lvd2/yolka/hw/5v_4a_psu/dev_tps53015/dev_tps53015.kicad_pcb

## KiCad design hw/5v_4a_psu/dev_tps53015/dev_tps53015.kicad_pcb (2026-11-06)

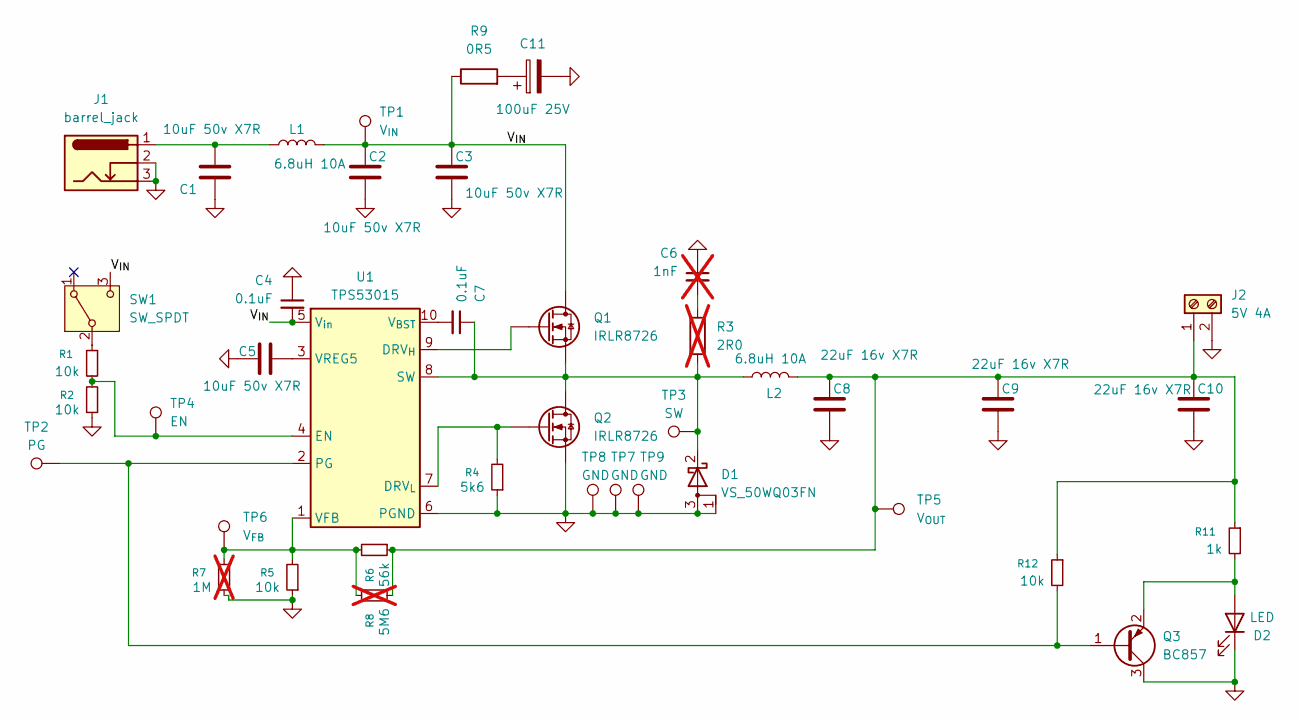
[picture p1: schematic dev_tps53015.kicad_sch]

Parts:
C1, C2, C3, C5: 10uF 50v X7R; C_1210_3225Metric_Pad1.33x2.70mm_HandSolder
C4, C7: 0.1uF; C_0805_2012Metric_Pad1.18x1.45mm_HandSolder
C6: 1nF; C_0805_2012Metric_Pad1.18x1.45mm_HandSolder; not fitted
C8, C9, C10: 22uF 16v X7R; C_1210_3225Metric_Pad1.33x2.70mm_HandSolder
C11: 100uF 25V; CP_Radial_D6.3mm_P2.50mm
D1: VS_50WQ03FN; TO-252-2
D2: LED; LED_0805_2012Metric
J1: barrel_jack; BarrelJack_Horizontal
J2: 5V 4A; KF7.62-2
L1, L2: 6.8uH 10A; univ_12x12_inductor
Q1, Q2: IRLR8726; TO-252-FET
Q3: BC857; SOT-23_Handsoldering
R1, R2, R5, R12: 10k; R_0805_2012Metric_Pad1.20x1.40mm_HandSolder
R3: 2R0; R_1206_3216Metric_Pad1.30x1.75mm_HandSolder; not fitted
R4: 5k6; R_0805_2012Metric_Pad1.20x1.40mm_HandSolder
R6: 56k; R_0805_2012Metric_Pad1.20x1.40mm_HandSolder
R7: 1M; R_0805_2012Metric_Pad1.20x1.40mm_HandSolder; not fitted
R8: 5M6; R_0805_2012Metric_Pad1.20x1.40mm_HandSolder; not fitted
R9: 0R5; R_1206_3216Metric_Pad1.30x1.75mm_HandSolder
R11: 1k; R_0805_2012Metric_Pad1.20x1.40mm_HandSolder
SW1: SW_SPDT; SW_SPDT_PCM12
TP1: V_{IN}; PinHeader_1x01_P2.54mm_Vertical
TP2: PG; PinHeader_1x01_P2.54mm_Vertical
TP3: SW; PinHeader_1x01_P2.54mm_Vertical
TP4: EN; PinHeader_1x01_P2.54mm_Vertical
TP5: V_{OUT}; PinHeader_1x01_P2.54mm_Vertical
TP6: V_{FB}; PinHeader_1x01_P2.54mm_Vertical
TP7, TP8, TP9: GND; PinHeader_1x01_P2.54mm_Vertical
U1: TPS53015; VSSOP-10_3x3mm_P0.5mm

Connections:
/V_{IN}: C2.1, C3.1, C4.2, L1.2, Q1.D, R9.1, SW1.3 (C), TP1.1, U1.5 (V_{in})
GND: C1.2, C2.2, C3.2, C4.1, C5.2, C6.1, C8.2, C9.2, C10.2, C11.2, D1.1 (A), D1.3 (A), D2.1 (K), J1.2, J1.3, J2.2, Q2.S, Q3.3 (C), R2.1, R4.1, R5.1, R7.1, SW1.4, TP7.1, TP8.1, TP9.1, U1.6 (PGND)
unnamed: C1.1, J1.1, L1.1
unnamed: C6.2, R3.1
unnamed: C11.1, R9.2
unnamed: C7.1, D1.2 (K), L2.1, Q1.S, Q2.D, R3.2, TP3.1, U1.8 (SW)
unnamed: D2.2 (A), Q3.2 (E), R11.2
unnamed: C8.1, C9.1, C10.1, J2.1, L2.2, R6.1, R8.1, R11.1, R12.1, TP5.1
unnamed: Q3.1 (B), R12.2, TP2.1, U1.2 (PG)
unnamed: R1.1, SW1.2 (B)
unnamed: Q1.G, U1.9 (DRV_{H})
unnamed: Q2.G, R4.2, U1.7 (DRV_{L})
unnamed: R1.2, R2.2, TP4.1, U1.4 (EN)
unnamed: R5.2, R6.2, R7.2, R8.2, TP6.1, U1.1 (VFB)
unnamed: C5.1, U1.3 (VREG5)
unnamed: C7.2, U1.10 (V_{BST})

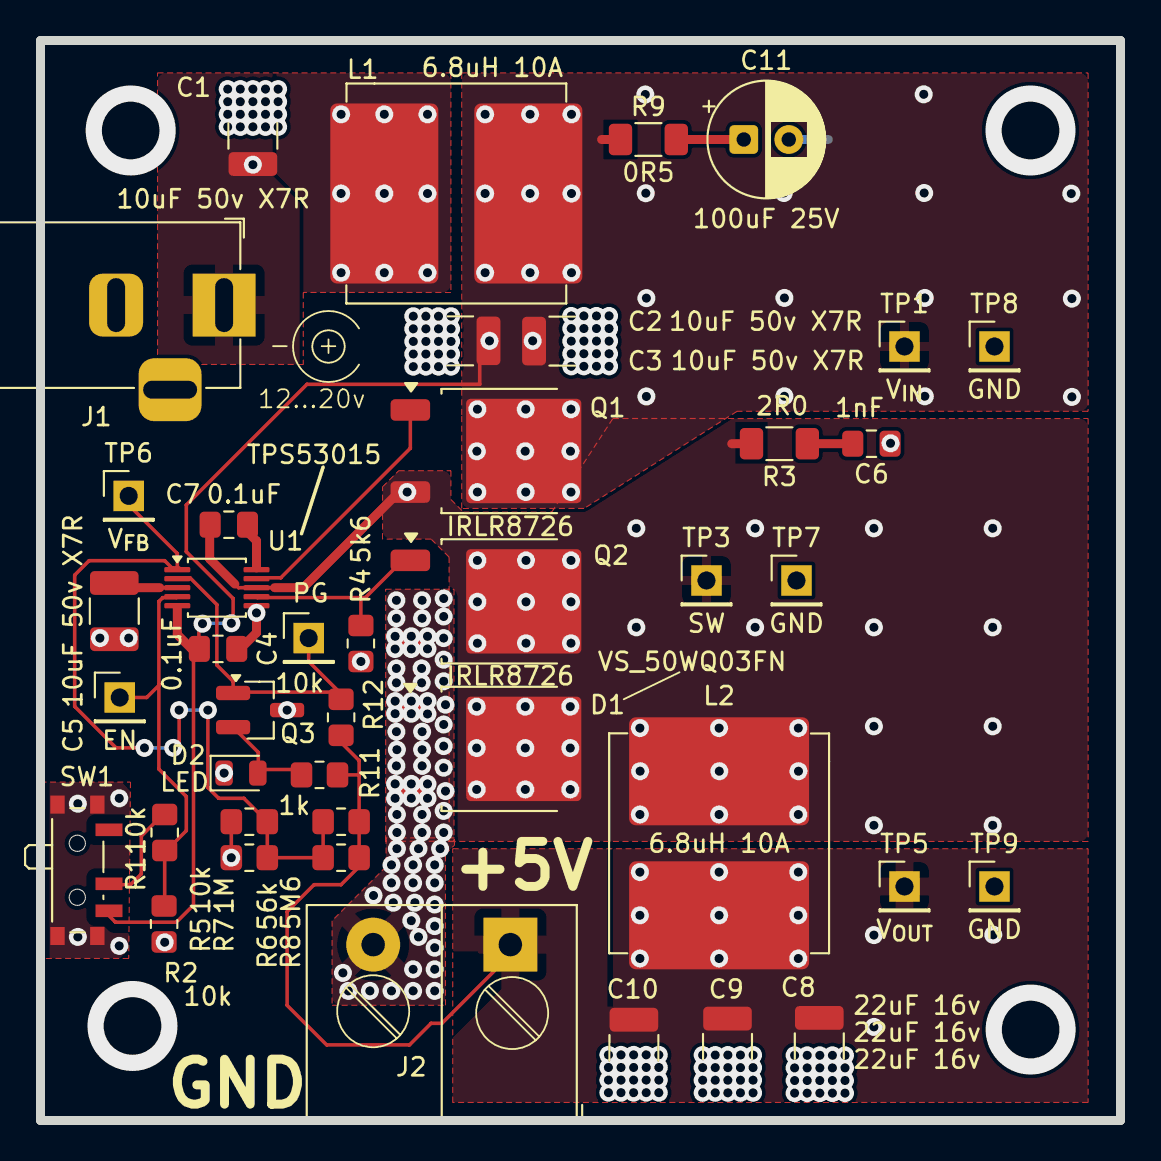
[picture p2: board dev_tps53015.kicad_pcb from above]

Board: 2 copper layers, 60.0 x 60.0 mm, 42 parts (0 on the bottom side), 16 nets.
