lvd2/yolka/hw/main_board/yolka/yolka.kicad_pcb

## KiCad design hw/main_board/yolka/yolka.kicad_pcb (2026-11-06)

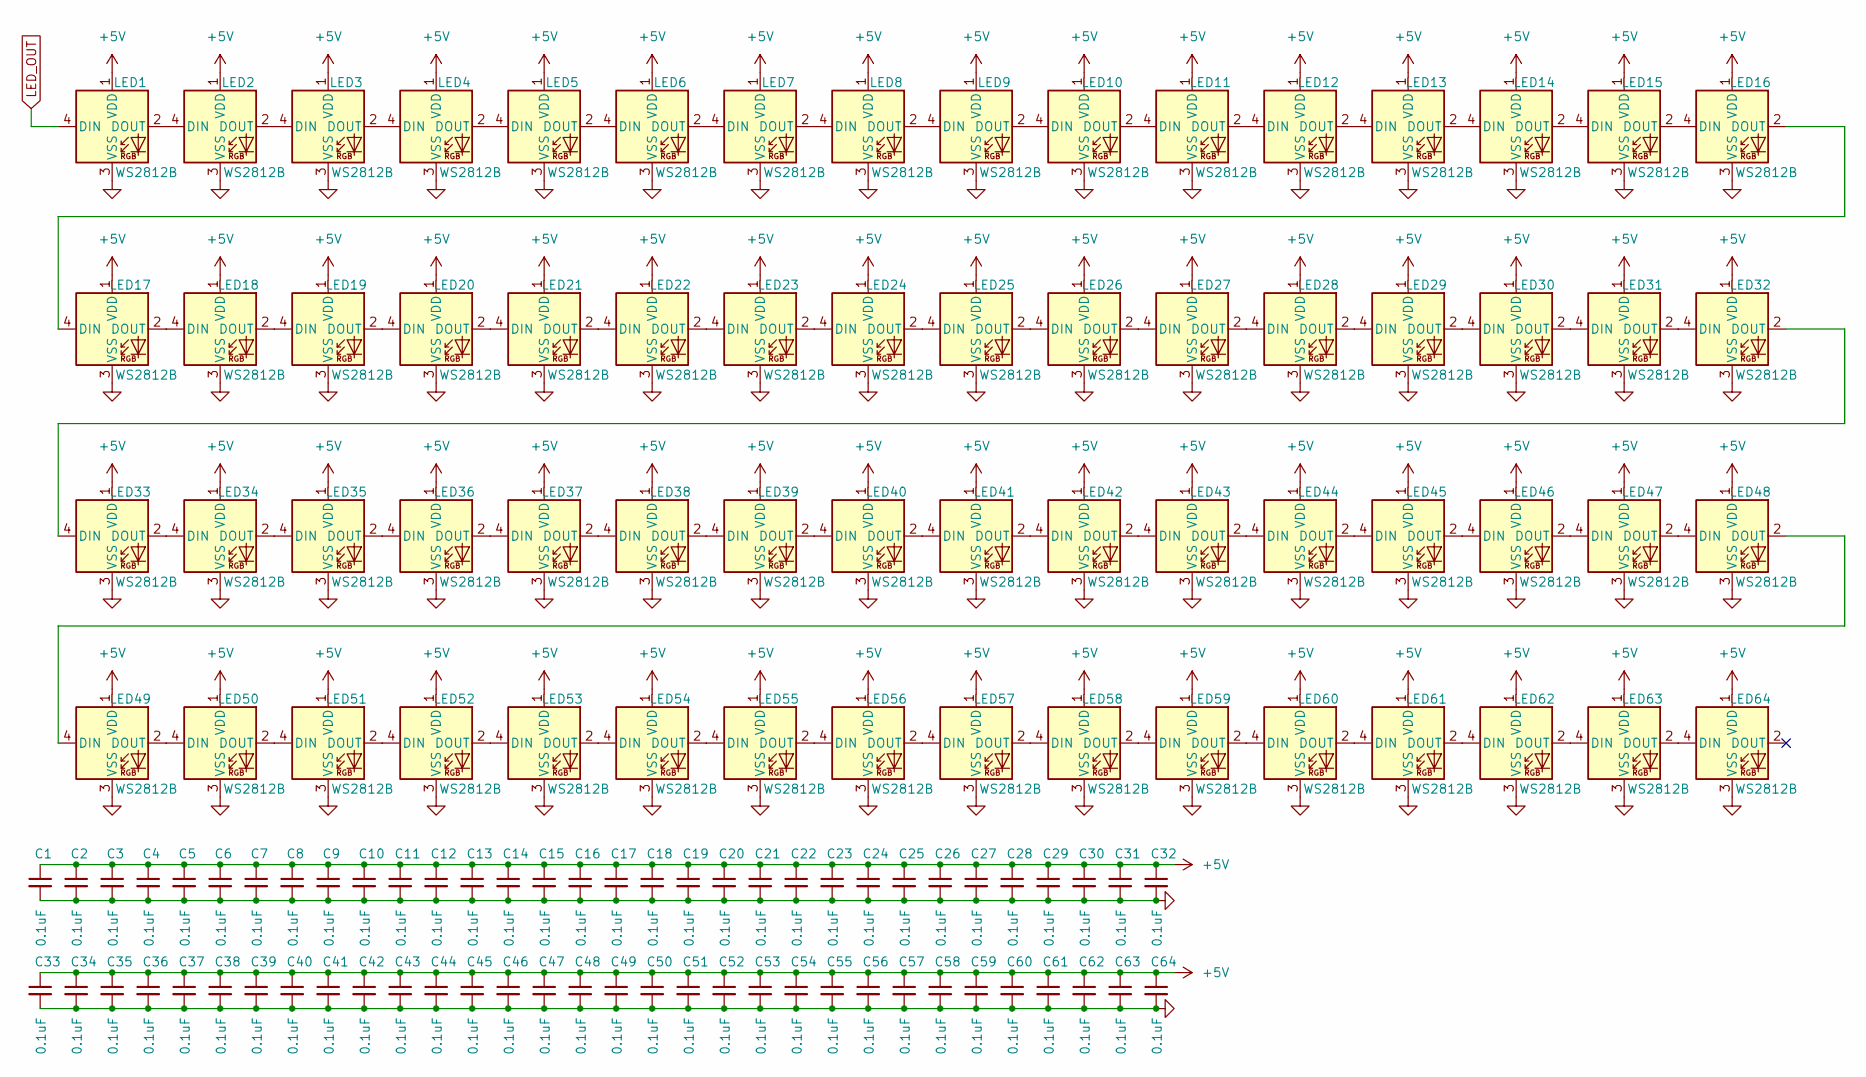
[picture p3: schematic leds.kicad_sch]

Parts:
C1, C2, C3, C4, C5, C6, C7, C8, C9, C10, C11, C12, C13, C14, C15, C16, C17, C18, C19, C20, C21, C22, C23, C24, C25, C26, C27, C28, C29, C30, C31, C32, C33, C34, C35, C36, C37, C38, C39, C40, C41, C42, C43, C44, C45, C46, C47, C48, C49, C50, C51, C52, C53, C54, C55, C56, C57, C58, C59, C60, C61, C62, C63, C64: 0.1uF; C_0805_2012Metric_Pad1.18x1.45mm_HandSolder
LED1, LED2, LED3, LED4, LED5, LED6, LED7, LED8, LED9, LED10, LED11, LED12, LED13, LED14, LED15, LED16, LED17, LED18, LED19, LED20, LED21, LED22, LED23, LED24, LED25, LED26, LED27, LED28, LED29, LED30, LED31, LED32, LED33, LED34, LED35, LED36, LED37, LED38, LED39, LED40, LED41, LED42, LED43, LED44, LED45, LED46, LED47, LED48, LED49, LED50, LED51, LED52, LED53, LED54, LED55, LED56, LED57, LED58, LED59, LED60, LED61, LED62, LED63, LED64: WS2812B; LED_WS2812B_PLCC4_5.0x5.0mm_P3.2mm

Connections:
+5V: C1.1, C2.1, C3.1, C4.1, C5.1, C6.1, C7.1, C8.1, C9.1, C10.1, C11.1, C12.1, C13.1, C14.1, C15.1, C16.1, C17.1, C18.1, C19.1, C20.1, C21.1, C22.1, C23.1, C24.1, C25.1, C26.1, C27.1, C28.1, C29.1, C30.1, C31.1, C32.1, C33.1, C34.1, C35.1, C36.1, C37.1, C38.1, C39.1, C40.1, C41.1, C42.1, C43.1, C44.1, C45.1, C46.1, C47.1, C48.1, C49.1, C50.1, C51.1, C52.1, C53.1, C54.1, C55.1, C56.1, C57.1, C58.1, C59.1, C60.1, C61.1, C62.1, C63.1, C64.1, LED1.1 (VDD), LED2.1 (VDD), LED3.1 (VDD), LED4.1 (VDD), LED5.1 (VDD), LED6.1 (VDD), LED7.1 (VDD), LED8.1 (VDD), LED9.1 (VDD), LED10.1 (VDD), LED11.1 (VDD), LED12.1 (VDD), LED13.1 (VDD), LED14.1 (VDD), LED15.1 (VDD), LED16.1 (VDD), LED17.1 (VDD), LED18.1 (VDD), LED19.1 (VDD), LED20.1 (VDD), LED21.1 (VDD), LED22.1 (VDD), LED23.1 (VDD), LED24.1 (VDD), LED25.1 (VDD), LED26.1 (VDD), LED27.1 (VDD), LED28.1 (VDD), LED29.1 (VDD), LED30.1 (VDD), LED31.1 (VDD), LED32.1 (VDD), LED33.1 (VDD), LED34.1 (VDD), LED35.1 (VDD), LED36.1 (VDD), LED37.1 (VDD), LED38.1 (VDD), LED39.1 (VDD), LED40.1 (VDD), LED41.1 (VDD), LED42.1 (VDD), LED43.1 (VDD), LED44.1 (VDD), LED45.1 (VDD), LED46.1 (VDD), LED47.1 (VDD), LED48.1 (VDD), LED49.1 (VDD), LED50.1 (VDD), LED51.1 (VDD), LED52.1 (VDD), LED53.1 (VDD), LED54.1 (VDD), LED55.1 (VDD), LED56.1 (VDD), LED57.1 (VDD), LED58.1 (VDD), LED59.1 (VDD), LED60.1 (VDD), LED61.1 (VDD), LED62.1 (VDD), LED63.1 (VDD), LED64.1 (VDD); also elsewhere on the board
GND: C1.2, C2.2, C3.2, C4.2, C5.2, C6.2, C7.2, C8.2, C9.2, C10.2, C11.2, C12.2, C13.2, C14.2, C15.2, C16.2, C17.2, C18.2, C19.2, C20.2, C21.2, C22.2, C23.2, C24.2, C25.2, C26.2, C27.2, C28.2, C29.2, C30.2, C31.2, C32.2, C33.2, C34.2, C35.2, C36.2, C37.2, C38.2, C39.2, C40.2, C41.2, C42.2, C43.2, C44.2, C45.2, C46.2, C47.2, C48.2, C49.2, C50.2, C51.2, C52.2, C53.2, C54.2, C55.2, C56.2, C57.2, C58.2, C59.2, C60.2, C61.2, C62.2, C63.2, C64.2, LED1.3 (VSS), LED2.3 (VSS), LED3.3 (VSS), LED4.3 (VSS), LED5.3 (VSS), LED6.3 (VSS), LED7.3 (VSS), LED8.3 (VSS), LED9.3 (VSS), LED10.3 (VSS), LED11.3 (VSS), LED12.3 (VSS), LED13.3 (VSS), LED14.3 (VSS), LED15.3 (VSS), LED16.3 (VSS), LED17.3 (VSS), LED18.3 (VSS), LED19.3 (VSS), LED20.3 (VSS), LED21.3 (VSS), LED22.3 (VSS), LED23.3 (VSS), LED24.3 (VSS), LED25.3 (VSS), LED26.3 (VSS), LED27.3 (VSS), LED28.3 (VSS), LED29.3 (VSS), LED30.3 (VSS), LED31.3 (VSS), LED32.3 (VSS), LED33.3 (VSS), LED34.3 (VSS), LED35.3 (VSS), LED36.3 (VSS), LED37.3 (VSS), LED38.3 (VSS), LED39.3 (VSS), LED40.3 (VSS), LED41.3 (VSS), LED42.3 (VSS), LED43.3 (VSS), LED44.3 (VSS), LED45.3 (VSS), LED46.3 (VSS), LED47.3 (VSS), LED48.3 (VSS), LED49.3 (VSS), LED50.3 (VSS), LED51.3 (VSS), LED52.3 (VSS), LED53.3 (VSS), LED54.3 (VSS), LED55.3 (VSS), LED56.3 (VSS), LED57.3 (VSS), LED58.3 (VSS), LED59.3 (VSS), LED60.3 (VSS), LED61.3 (VSS), LED62.3 (VSS), LED63.3 (VSS), LED64.3 (VSS); also elsewhere on the board
LED_OUT: LED1.4 (DIN); also elsewhere on the board
unnamed: LED1.2 (DOUT), LED2.4 (DIN)
unnamed: LED2.2 (DOUT), LED3.4 (DIN)
unnamed: LED3.2 (DOUT), LED4.4 (DIN)
unnamed: LED4.2 (DOUT), LED5.4 (DIN)
unnamed: LED5.2 (DOUT), LED6.4 (DIN)
unnamed: LED6.2 (DOUT), LED7.4 (DIN)
unnamed: LED7.2 (DOUT), LED8.4 (DIN)
unnamed: LED8.2 (DOUT), LED9.4 (DIN)
unnamed: LED9.2 (DOUT), LED10.4 (DIN)
unnamed: LED10.2 (DOUT), LED11.4 (DIN)
unnamed: LED11.2 (DOUT), LED12.4 (DIN)
unnamed: LED12.2 (DOUT), LED13.4 (DIN)
unnamed: LED13.2 (DOUT), LED14.4 (DIN)
unnamed: LED14.2 (DOUT), LED15.4 (DIN)
unnamed: LED15.2 (DOUT), LED16.4 (DIN)
unnamed: LED16.2 (DOUT), LED17.4 (DIN)
unnamed: LED17.2 (DOUT), LED18.4 (DIN)
unnamed: LED18.2 (DOUT), LED19.4 (DIN)
unnamed: LED19.2 (DOUT), LED20.4 (DIN)
unnamed: LED20.2 (DOUT), LED21.4 (DIN)
unnamed: LED21.2 (DOUT), LED22.4 (DIN)
unnamed: LED22.2 (DOUT), LED23.4 (DIN)
unnamed: LED23.2 (DOUT), LED24.4 (DIN)
unnamed: LED24.2 (DOUT), LED25.4 (DIN)
unnamed: LED25.2 (DOUT), LED26.4 (DIN)
unnamed: LED26.2 (DOUT), LED27.4 (DIN)
unnamed: LED27.2 (DOUT), LED28.4 (DIN)
unnamed: LED28.2 (DOUT), LED29.4 (DIN)
unnamed: LED29.2 (DOUT), LED30.4 (DIN)
unnamed: LED30.2 (DOUT), LED31.4 (DIN)
unnamed: LED31.2 (DOUT), LED32.4 (DIN)
unnamed: LED32.2 (DOUT), LED33.4 (DIN)
unnamed: LED33.2 (DOUT), LED34.4 (DIN)
unnamed: LED34.2 (DOUT), LED35.4 (DIN)
unnamed: LED35.2 (DOUT), LED36.4 (DIN)
unnamed: LED36.2 (DOUT), LED37.4 (DIN)
unnamed: LED37.2 (DOUT), LED38.4 (DIN)
unnamed: LED38.2 (DOUT), LED39.4 (DIN)
unnamed: LED39.2 (DOUT), LED40.4 (DIN)
unnamed: LED40.2 (DOUT), LED41.4 (DIN)
unnamed: LED41.2 (DOUT), LED42.4 (DIN)
unnamed: LED42.2 (DOUT), LED43.4 (DIN)
unnamed: LED43.2 (DOUT), LED44.4 (DIN)
unnamed: LED44.2 (DOUT), LED45.4 (DIN)
unnamed: LED45.2 (DOUT), LED46.4 (DIN)
unnamed: LED46.2 (DOUT), LED47.4 (DIN)
unnamed: LED47.2 (DOUT), LED48.4 (DIN)
unnamed: LED48.2 (DOUT), LED49.4 (DIN)
unnamed: LED49.2 (DOUT), LED50.4 (DIN)
unnamed: LED50.2 (DOUT), LED51.4 (DIN)
unnamed: LED51.2 (DOUT), LED52.4 (DIN)
unnamed: LED52.2 (DOUT), LED53.4 (DIN)
unnamed: LED53.2 (DOUT), LED54.4 (DIN)
unnamed: LED54.2 (DOUT), LED55.4 (DIN)
unnamed: LED55.2 (DOUT), LED56.4 (DIN)
unnamed: LED56.2 (DOUT), LED57.4 (DIN)
unnamed: LED57.2 (DOUT), LED58.4 (DIN)
unnamed: LED58.2 (DOUT), LED59.4 (DIN)
unnamed: LED59.2 (DOUT), LED60.4 (DIN)
unnamed: LED60.2 (DOUT), LED61.4 (DIN)
unnamed: LED61.2 (DOUT), LED62.4 (DIN)
unnamed: LED62.2 (DOUT), LED63.4 (DIN)
unnamed: LED63.2 (DOUT), LED64.4 (DIN)

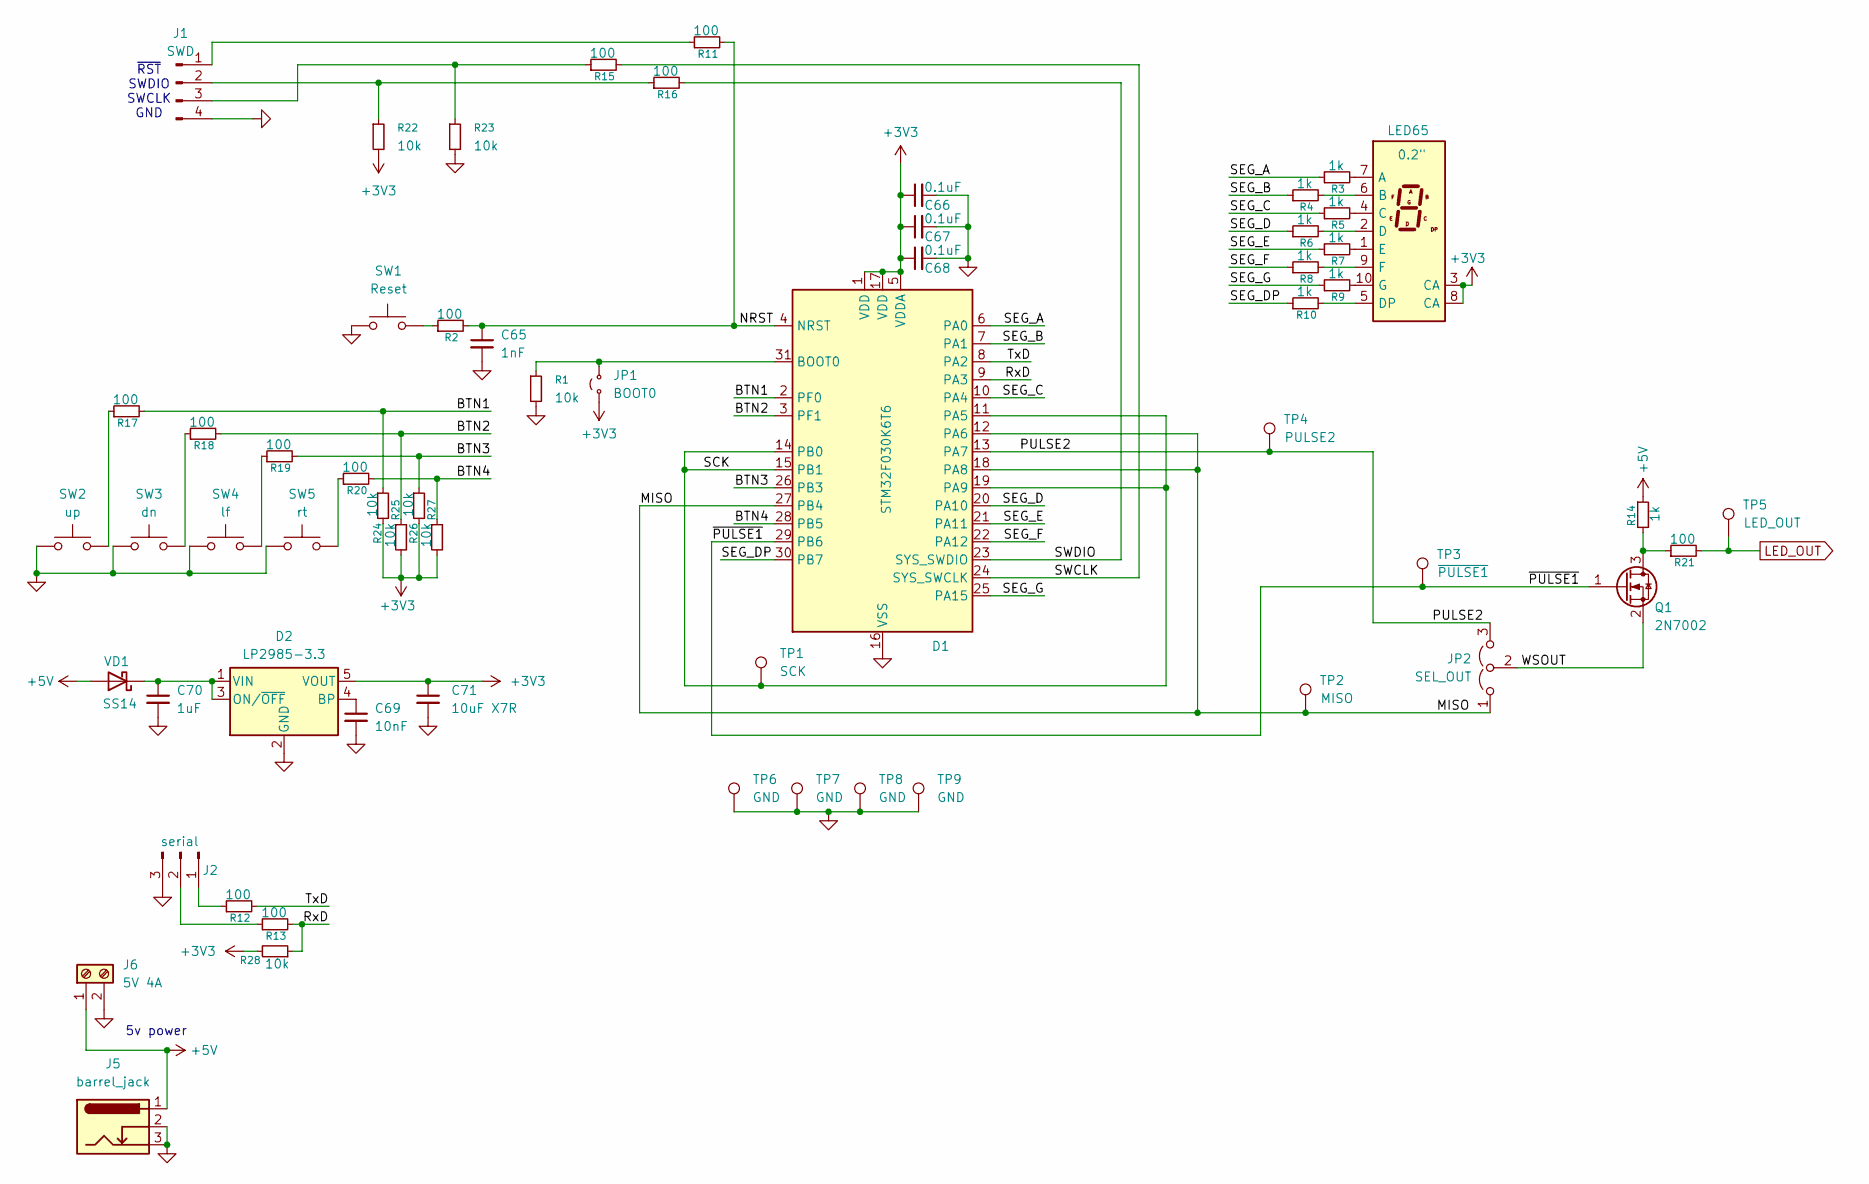
[picture p4: schematic mcu.kicad_sch]

Parts:
C65: 1nF; C_0805_2012Metric_Pad1.18x1.45mm_HandSolder
C66, C67, C68: 0.1uF; C_0805_2012Metric_Pad1.18x1.45mm_HandSolder
C69: 10nF; C_0805_2012Metric_Pad1.18x1.45mm_HandSolder
C70: 1uF; C_0805_2012Metric_Pad1.18x1.45mm_HandSolder
C71: 10uF X7R; C_1206_3216Metric_Pad1.33x1.80mm_HandSolder
D1: STM32F030K6T6; LQFP-32_7x7mm_P0.8mm
D2: LP2985-3.3; SOT-23-5
J1: SWD; PinHeader_1x04_P2.54mm_Horizontal
J2: serial; PinHeader_1x03_P2.54mm_Horizontal
J5: barrel_jack; BarrelJack_Horizontal
J6: 5V 4A; KF7.62-2
JP1: BOOT0; PinHeader_1x02_P2.54mm_Horizontal
JP2: SEL_OUT; PinHeader_1x03_P2.54mm_Horizontal
LED65: 0.2"; KCSC02-105
Q1: 2N7002; SOT-23
R1, R22, R23, R24, R25, R26, R27, R28: 10k; R_0805_2012Metric_Pad1.20x1.40mm_HandSolder
R2, R11, R12, R13, R15, R16, R17, R18, R19, R20, R21: 100; R_0805_2012Metric_Pad1.20x1.40mm_HandSolder
R3, R4, R5, R6, R7, R8, R9, R10, R14: 1k; R_0805_2012Metric_Pad1.20x1.40mm_HandSolder
SW1: Reset; SW_Push_1P1T_sunrom_7615
SW2: up; SW_Push_1P1T_sunrom_7615
SW3: dn; SW_Push_1P1T_sunrom_7615
SW4: lf; SW_Push_1P1T_sunrom_7615
SW5: rt; SW_Push_1P1T_sunrom_7615
TP1: SCK; PinHeader_1x01_P2.54mm_Vertical
TP2: MISO; PinHeader_1x01_P2.54mm_Vertical
TP3: ~{PULSE1}; PinHeader_1x01_P2.54mm_Vertical
TP4: PULSE2; PinHeader_1x01_P2.54mm_Vertical
TP5: LED_OUT; PinHeader_1x01_P2.54mm_Vertical
TP6, TP7, TP8, TP9: GND; PinHeader_1x01_P2.54mm_Vertical
VD1: SS14; D_SMA

Connections:
+3V3: C66.1, C67.1, C68.1, C71.1, D1.1 (VDD), D1.5 (VDDA), D1.17 (VDD), D2.5 (VOUT), JP1.1 (A), LED65.3 (CA), LED65.8 (CA), R22.2, R24.2, R25.2, R26.2, R27.2, R28.2
+5V: J5.1, J6.1, R14.1, VD1.2 (A); also elsewhere on the board
/MCU/BTN1: D1.2 (PF0), R17.2, R24.1
/MCU/BTN2: D1.3 (PF1), R18.2, R25.1
/MCU/BTN3: D1.26 (PB3), R19.2, R26.1
/MCU/BTN4: D1.28 (PB5), R20.2, R27.1
/MCU/MISO: D1.12 (PA6), D1.18 (PA8), D1.27 (PB4), JP2.1 (A), TP2.1
/MCU/NRST: C65.1, D1.4 (NRST), R2.2, R11.2
/MCU/PULSE2: D1.13 (PA7), JP2.3 (B), TP4.1
/MCU/RxD: D1.9 (PA3), R13.2, R28.1
/MCU/SCK: D1.11 (PA5), D1.14 (PB0), D1.15 (PB1), D1.19 (PA9), TP1.1
/MCU/SEG_A: D1.6 (PA0), R3.1
/MCU/SEG_B: D1.7 (PA1), R4.1
/MCU/SEG_C: D1.10 (PA4), R5.1
/MCU/SEG_D: D1.20 (PA10), R6.1
/MCU/SEG_DP: D1.30 (PB7), R10.1
/MCU/SEG_E: D1.21 (PA11), R7.1
/MCU/SEG_F: D1.22 (PA12), R8.1
/MCU/SEG_G: D1.25 (PA15), R9.1
/MCU/SWCLK: D1.24 (SYS_SWCLK), R15.2
/MCU/SWDIO: D1.23 (SYS_SWDIO), R16.2
/MCU/TxD: D1.8 (PA2), R12.2
/MCU/WSOUT: JP2.2 (C), Q1.2 (S)
/MCU/~PULSE1: D1.29 (PB6), Q1.1 (G), TP3.1
GND: C65.2, C66.2, C67.2, C68.2, C69.2, C70.2, C71.2, D1.16 (VSS), D1.32 (VSS), D2.2 (GND), J1.4, J2.3, J5.2, J5.3, J6.2, R1.2, R23.2, SW1.1, SW2.1, SW3.1, SW4.1, SW5.1, TP6.1, TP7.1, TP8.1, TP9.1; also elsewhere on the board
LED_OUT: R21.2, TP5.1; also elsewhere on the board
unnamed: D1.31 (BOOT0), JP1.2 (B), R1.1
unnamed: C69.1, D2.4 (BP)
unnamed: C70.1, D2.1 (VIN), D2.3 (ON/~OFF), VD1.1 (K)
unnamed: J1.1, R11.1
unnamed: J1.2, R16.1, R22.1
unnamed: J1.3, R15.1, R23.1
unnamed: J2.1, R12.1
unnamed: J2.2, R13.1
unnamed: LED65.7 (A), R3.2
unnamed: LED65.6 (B), R4.2
unnamed: LED65.4 (C), R5.2
unnamed: LED65.2 (D), R6.2
unnamed: LED65.5 (DP), R10.2
unnamed: LED65.1 (E), R7.2
unnamed: LED65.9 (F), R8.2
unnamed: LED65.10 (G), R9.2
unnamed: Q1.3 (D), R14.2, R21.1
unnamed: R2.1, SW1.2
unnamed: R17.1, SW2.2
unnamed: R18.1, SW3.2
unnamed: R19.1, SW4.2
unnamed: R20.1, SW5.2

Notes on the sheet:
5v power
~{RST} SWDIO SWCLK GND

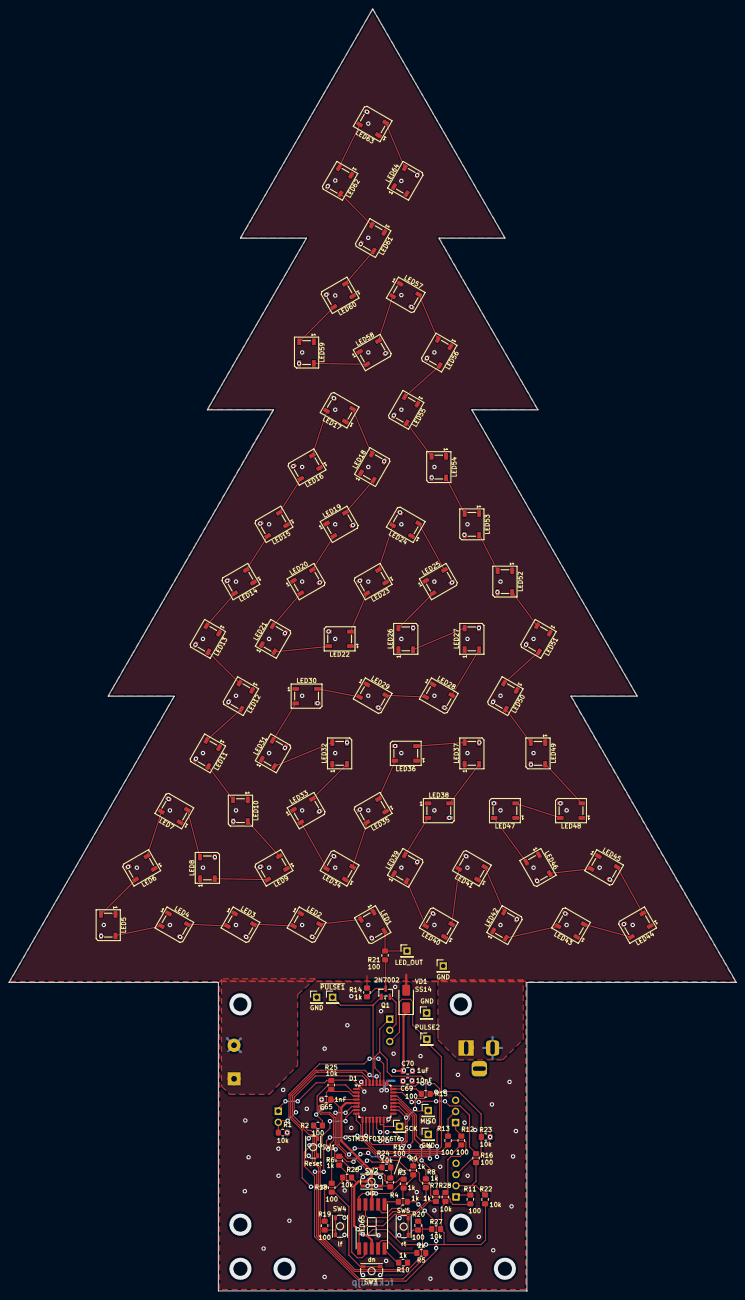
[picture p5: board yolka.kicad_pcb from above]

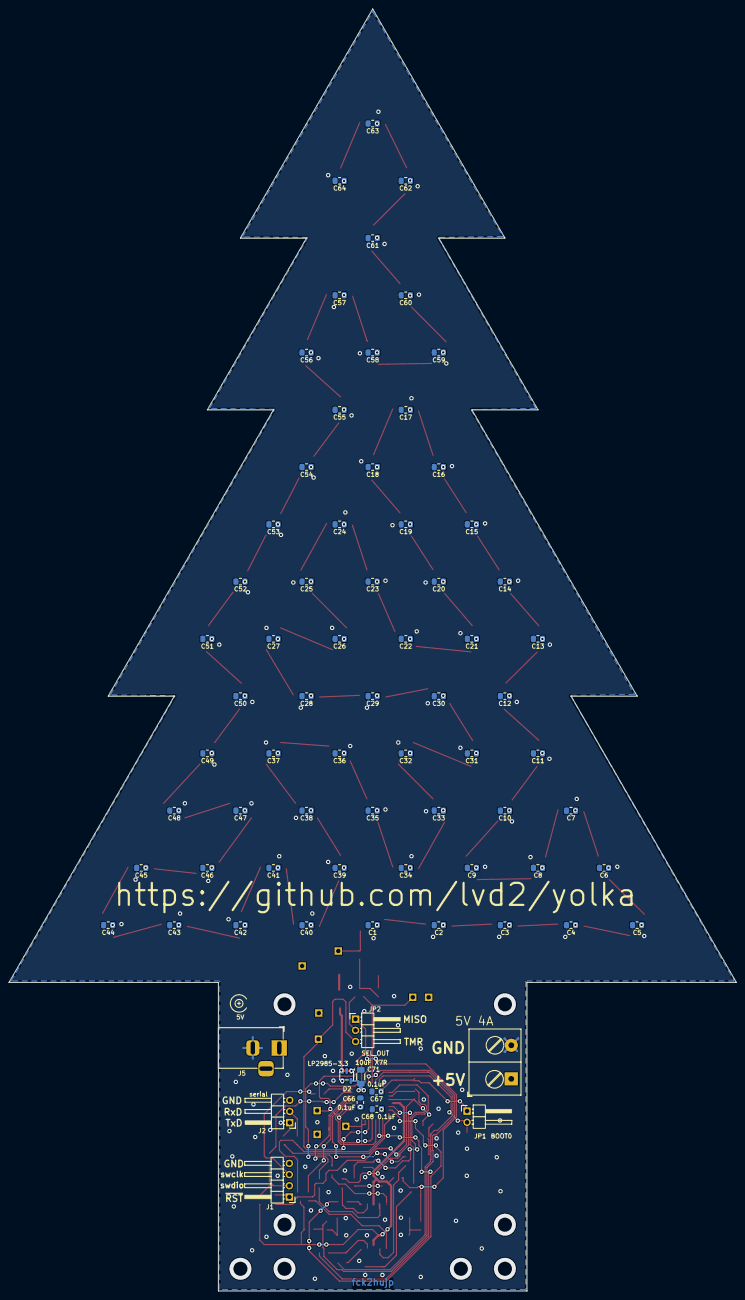
[picture p6: board yolka.kicad_pcb from below]

Board: 2 copper layers, 165.0 x 290.8 mm, 188 parts (75 on the bottom side), 111 nets.
