lvd2/yolka/(commit log)

2026-11-06 add sch/pcb parts of the design
    [dev_tps53015-B_Cu.gbr, dev_tps53015-B_Mask.gbr, dev_tps53015-B_Silkscreen.gbr, dev_tps53015-Edge_Cuts.gbr, dev_tps53015-F_Cu.gbr, dev_tps53015-F_Mask.gbr, dev_tps53015-F_Silkscreen.gbr, dev_tps53015-NPTH.drl]
2026-11-06 add ws2812 test code from unrelated project (to be fixed for this board)
    [main.c, startup.c]
2026-11-07 mcu: update ws2818 test for the board (PB6=1 for fet gate)
2026-11-14 mcu: move bitscripts stuff to test_ws2812_2, fix python script for older objcopy versions, test on HW (works)
    [mk_io_script.py]
